SpaceBod/EIE2-MarsRover/img/title.jpg

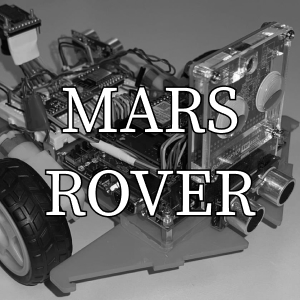
img/title.jpg
