SpaceBod/EIE2-MarsRover/Project Files/Control/main_STRAIGHTLINE.cpp

#include <Arduino.h>
#include "SPI.h"
#include <Robojax_L298N_DC_motor.h>
#include <iostream>
//#include "ADNS3080_PROGRAM.cpp"
//#include "MOTOR_CONTROL_ESP32.cpp"
// these pins may be different on different boards

#define PIN_SS        5
#define PIN_MISO      19
#define PIN_MOSI      23
#define PIN_SCK       18

#define PIN_MOUSECAM_RESET     17
#define PIN_MOUSECAM_CS        5

#define ADNS3080_PIXELS_X                 30
#define ADNS3080_PIXELS_Y                 30

#define ADNS3080_PRODUCT_ID            0x00
#define ADNS3080_REVISION_ID           0x01
#define ADNS3080_MOTION                0x02
#define ADNS3080_DELTA_X               0x03
#define ADNS3080_DELTA_Y               0x04
#define ADNS3080_SQUAL                 0x05
#define ADNS3080_PIXEL_SUM             0x06
#define ADNS3080_MAXIMUM_PIXEL         0x07
#define ADNS3080_CONFIGURATION_BITS    0x0a
#define ADNS3080_EXTENDED_CONFIG       0x0b
#define ADNS3080_DATA_OUT_LOWER        0x0c
#define ADNS3080_DATA_OUT_UPPER        0x0d
#define ADNS3080_SHUTTER_LOWER         0x0e
#define ADNS3080_SHUTTER_UPPER         0x0f
#define ADNS3080_FRAME_PERIOD_LOWER    0x10
#define ADNS3080_FRAME_PERIOD_UPPER    0x11
#define ADNS3080_MOTION_CLEAR          0x12
#define ADNS3080_FRAME_CAPTURE         0x13
#define ADNS3080_SROM_ENABLE           0x14
#define ADNS3080_FRAME_PERIOD_MAX_BOUND_LOWER      0x19
#define ADNS3080_FRAME_PERIOD_MAX_BOUND_UPPER      0x1a
#define ADNS3080_FRAME_PERIOD_MIN_BOUND_LOWER      0x1b
#define ADNS3080_FRAME_PERIOD_MIN_BOUND_UPPER      0x1c
#define ADNS3080_SHUTTER_MAX_BOUND_LOWER           0x1e
#define ADNS3080_SHUTTER_MAX_BOUND_UPPER           0x1e
#define ADNS3080_SROM_ID               0x1f
#define ADNS3080_OBSERVATION           0x3d
#define ADNS3080_INVERSE_PRODUCT_ID    0x3f
#define ADNS3080_PIXEL_BURST           0x40
#define ADNS3080_MOTION_BURST          0x50
#define ADNS3080_SROM_LOAD             0x60

#define ADNS3080_PRODUCT_ID_VAL        0x17
// right settings
#define CHA 0
#define ENA 2 // this pin must be PWM enabled pin if Arduino board is used
#define IN1 15
#define IN2 4
// left settings
#define IN3 14
#define IN4 16
#define ENB 22 // this pin must be PWM enabled pin if Arduino board is used
#define CHB 1
const int CCW = 2; // do not change
const int CW  = 1; // do not change
#define right_motor 1 // do not change
#define left_motor 2 // do not change
// for two motors without debug information // Watch video instruciton for this line: https://youtu.be/2JTMqURJTwg
Robojax_L298N_DC_motor robot(IN1, IN2, ENA, CHA,  IN3, IN4, ENB, CHB);

/*
#define CHA 0
#define ENA 32 // this pin must be PWM enabled pin if Arduino board is used
#define IN1 25
#define IN2 33
// left settings
#define IN3 26
#define IN4 27
#define ENB 4 // this pin must be PWM enabled pin if Arduino board is used
#define CHB 1
const int CCW = 2; // do not change
const int CW  = 1; // do not change
#define right_motor 1 // do not change
#define left_motor 2 // do not change
// for two motors without debug information // Watch video instruciton for this line: https://youtu.be/2JTMqURJTwg
Robojax_L298N_DC_motor robot(IN1, IN2, ENA, CHA,  IN3, IN4, ENB, CHB);
*/
float total_x = 0;
float total_y = 0;
float total = 0;


float total_x1 = 0;
float total_y1 = 0;


int x=0;
int y=0;

int a=0;
int b=0;

float distance_x=0;
float distance_y=0;

volatile byte movementflag=0;
volatile int xydat[2];


int convTwosComp(int b){
  //Convert from 2's complement
  if(b & 0x80){
    b = -1 * ((b ^ 0xff) + 1);
    }
  return b;
  }


int tdistance = 0;


void mousecam_reset()
{
  digitalWrite(PIN_MOUSECAM_RESET,HIGH);
  delay(1); // reset pulse >10us
  digitalWrite(PIN_MOUSECAM_RESET,LOW);
  delay(35); // 35ms from reset to functional extended configuration in the datasheet
}


int mousecam_init()
{
  pinMode(PIN_MOUSECAM_RESET,OUTPUT);
  pinMode(PIN_MOUSECAM_CS,OUTPUT);

  digitalWrite(PIN_MOUSECAM_CS,HIGH);

  mousecam_reset();
  return 1;
}

void mousecam_write_reg(int reg, int val)
{
  digitalWrite(PIN_MOUSECAM_CS, LOW);
  SPI.transfer(reg | 0x80);
  SPI.transfer(val);
  digitalWrite(PIN_MOUSECAM_CS,HIGH);
  delayMicroseconds(1);
}

int mousecam_read_reg(int reg)
{
  digitalWrite(PIN_MOUSECAM_CS, LOW);
  SPI.transfer(reg);
  delayMicroseconds(1);
  int ret = SPI.transfer(0xff);
  digitalWrite(PIN_MOUSECAM_CS,HIGH);
  delayMicroseconds(1);
  return ret;
}

struct MD
{
 byte motion;
 int dx, dy;
 byte squal;
 word shutter;
 byte max_pix;
 int x,y;
};


void mousecam_read_motion(struct MD *p)
{
  digitalWrite(PIN_MOUSECAM_CS, LOW);
  SPI.transfer(ADNS3080_MOTION_BURST);
  delayMicroseconds(1);
  p->motion =  SPI.transfer(0xff);
  p->dx =  SPI.transfer(0xff);
  p->dy =  SPI.transfer(0xff);
  p->squal =  SPI.transfer(0xff);
  p->shutter =  SPI.transfer(0xff)<<8;
  p->shutter |=  SPI.transfer(0xff);
  p->max_pix =  SPI.transfer(0xff);
  digitalWrite(PIN_MOUSECAM_CS,HIGH);
  delayMicroseconds(1);
}

// pdata must point to an array of size ADNS3080_PIXELS_X x ADNS3080_PIXELS_Y
// you must call mousecam_reset() after this if you want to go back to normal operation
int mousecam_frame_capture(byte *pdata)
{
  mousecam_write_reg(ADNS3080_FRAME_CAPTURE,0x83);

  digitalWrite(PIN_MOUSECAM_CS, LOW);

  SPI.transfer(ADNS3080_PIXEL_BURST);
  delayMicroseconds(1);

  int pix;
  byte started = 0;
  int count;
  int timeout = 0;
  int ret = 0;
  for(count = 0; count < ADNS3080_PIXELS_X * ADNS3080_PIXELS_Y; )
  {
    pix = SPI.transfer(0xff);
    delayMicroseconds(10);
    if(started==0)
    {
      if(pix&0x40)
        started = 1;
      else
      {
        timeout++;
        if(timeout==100)
        {
          ret = -1;
          break;
        }
      }
    }
    if(started==1)
    {
      pdata[count++] = (pix & 0x3f)<<2; // scale to normal grayscale byte range
    }
  }

  digitalWrite(PIN_MOUSECAM_CS,HIGH);
  delayMicroseconds(14);

  return ret;
}
  
int counter =0;
float total_dy= 0;
float average_dy = 0;
void setup()
{  

  Serial.begin(115200);
  robot.begin();
  //L298N DC Motor by Robojax.com
  pinMode(PIN_SS,OUTPUT);
  pinMode(PIN_MISO,INPUT);
  pinMode(PIN_MOSI,OUTPUT);
  pinMode(PIN_SCK,OUTPUT);

  SPI.begin();
  SPI.setClockDivider(SPI_CLOCK_DIV32);
  SPI.setDataMode(SPI_MODE3);
  SPI.setBitOrder(MSBFIRST);

  Serial.begin(9600);

  if(mousecam_init()==-1)
  {
    Serial.println("Mouse cam failed to init");
    while(1);
  }
}

char asciiart(int k)
{
  static char foo[] = "WX86*3I>!;~:,`. ";
  return foo[k>>4];
}

byte frame[ADNS3080_PIXELS_X * ADNS3080_PIXELS_Y];

void loop()
{
  bool out_of_range = false;
    if(movementflag){

    tdistance = tdistance + convTwosComp(xydat[0]);
    Serial.println("Distance = " + String(tdistance));
    movementflag=0;
    delay(1);
    }

  
  // if enabled this section grabs frames and outputs them as ascii art
/*
  if(mousecam_frame_capture(frame)==0)
  {
    int i,j,k;
    for(i=0, k=0; i<ADNS3080_PIXELS_Y; i++)
    {
      for(j=0; j<ADNS3080_PIXELS_X; j++, k++)
      {
        Serial.print(asciiart(frame[k]));
        Serial.print(' ');
      }
      Serial.println();
    }
  }
  */
  Serial.println();
  delay(1);


  // if enabled this section produces a bar graph of the surface quality that can be used to focus the camera
  // also drawn is the average pixel value 0-63 and the shutter speed and the motion dx,dy.

  int val = mousecam_read_reg(ADNS3080_PIXEL_SUM);
  MD md;
  mousecam_read_motion(&md);
  for(int i=0; i<md.squal/4; i++)
    Serial.print('*');
  Serial.print(' ');
  Serial.print((val*100)/351);
  Serial.print(' ');
  Serial.print(md.shutter); Serial.print(" (");
  Serial.print((int)md.dx); Serial.print(',');
  Serial.print((int)md.dy); Serial.println(')');

  // Serial.println(md.max_pix);
  delay(1);


  distance_x = convTwosComp(md.dx);
  distance_y = convTwosComp(md.dy);

  total_x1 = total_x1 + distance_x;
  total_y1 = total_y1 + distance_y;
  md.y = md.y + 0.2*(float)md.dy;
  total_x = 0.2*total_x1;
  total_y = 0.2*total_y1;


  total_x = total_x1/157;
  total_y = total_y1/157;

  Serial.print('\n');


  Serial.println("Distance_x = " + String((float)((total_x))));
  Serial.println("Distance_y = " + String((float)((total_y))));
  Serial.print('\n');

  float real_x = (float)(total_x);
  Serial.println("real_x = " + String((float)((real_x))));
  Serial.println("md.dy = " + String((float)((md.dy))));
  if(md.y < 1000)
  {
    if (real_x>0)
    {
      real_x = sqrt(real_x*real_x);
      Serial.println("Left motor Speed: "+ String(78+10*(+real_x*real_x)));
      Serial.println("Right motor Speed: "+ String(70+10*(-real_x*real_x)));
      robot.rotate(left_motor, 80+10*(+real_x*real_x), CW);
      robot.rotate(right_motor, 80+10*(-real_x*real_x), CW);//run right_motor at 60% speed in CW direction
    }
    if (real_x<0)
    {
      real_x = sqrt(real_x*real_x);
      Serial.println("Right motor Speed: "+ String(80+10*(+real_x*real_x)));
      Serial.println("Left motor Speed: "+ String(70+10*(-real_x*real_x)));
      robot.rotate(right_motor, 80+10*(+real_x*real_x), CW);
      robot.rotate(left_motor, 80+10*(-real_x*real_x), CW);//run right_motor at 60% speed in CW direction
    }
    if(real_x == 0){
      robot.rotate(right_motor,80, CW);//run right_motor at 60% speed in CW direction
      robot.rotate(left_motor, 80, CW);//run right_motor at 60% speed in CW direction
    }
    if (md.y > 0)
    {
      counter = counter + 1;
      if(counter >= 6){
        total_dy = total_dy + md.dy;
        average_dy = total_dy / counter;
        if (average_dy + 10 > md.dy && average_dy - 10 < md.dy)
        {
          md.y = md.y + 0.2*(float)md.dy;
          out_of_range = true;
        }
        else{
          md.y = md.y + 0.2*average_dy;
        }
      }
    }
    Serial.println("Counter: "+String(counter));
    Serial.println("Average: "+String(average_dy));
    Serial.println("total y: "+String(total_dy));
    if(out_of_range)
    {
      Serial.println("md.dx OUT OF RANGE. Subsituted "+String(average_dy));
    }
    Serial.println("Distance: total md.y " + String(md.y));
  }
  else{
    robot.brake(1);
    robot.brake(2);  
  }
  delay(5);

}
