SpaceBod/EIE2-MarsRover/Project Files/Control/main_GETV2.cpp

#include <WiFi.h>
#include <HTTPClient.h>


#include <Arduino.h>

#include <SPI.h>
#include <Wire.h>
#include <MFRC522.h>

#include <stdint.h>
#include <string.h>
#include <stdio.h>

#include <WiFi.h>
#include <WiFiClient.h>
#include <HTTPClient.h>
#include <WiFiUdp.h>
#include <NTPClient.h>

#include <Arduino_JSON.h>


#include <Adafruit_Sensor.h>
#include <Adafruit_BME280.h>
  
const char* ssid = "LaptopWiFi";
const char* password =  "summerProject1234";
  
void setup() {
  
  Serial.begin(115200);
  delay(4000);
  WiFi.begin(ssid, password);
  
  while (WiFi.status() != WL_CONNECTED) {
    delay(1000);
    Serial.println("Connecting to WiFi..");
  }
  
  Serial.println("Connected to the WiFi network");
  
}
  
void loop() {
  
  if ((WiFi.status() == WL_CONNECTED)) { //Check the current connection status
  
    HTTPClient http;
  
    http.begin("http://jsonplaceholder.typicode.com/comments?id=10"); //Specify the URL
    int httpCode = http.GET();                                        //Make the request
  
    if (httpCode > 0) { //Check for the returning code
  
        String payload = http.getString();
        Serial.println(httpCode);
        Serial.println(payload);
      }
  
    else {
      Serial.println("Error on HTTP request");
    }
  
    http.end(); //Free the resources
  }
  
  delay(10000);
  
}
