SpaceBod/EIE2-MarsRover/(commit log)

2022-05-27 Basic Framework for Front-End
2022-05-28 Updated Framework
2022-06-03 gain/exposure fixed + BSP generated correctly
    [alt_sys_init.c, linker.h, main.c, system.h]
2022-06-13 Added Power Limit
2022-06-15 better bb and UART transmission
2022-06-24 Fixed register overflow & noise filter
    [EEE_IMGPROC.v, main.c, test.v, test_tb.v]
2022-06-25 add current code
2022-06-28 Fixed sat error & implemented building detection
    [EEE_IMGPROC.v, test.v, test_tb.v]
